Ahyaya/TinyTQ/README.md

# TinyTQ

## 概述

本装置是基于标准直齿轮的轨道演示装置（后称“装置”），用于展示天琴地心轨道设计的基本概念。天琴地心轨道的特点之一是星座平面在绕地心运行的同时会保持其朝向在惯性参考系中大致指向一个与黄道面平行的方向。

通过设计传动比，我们利用一对差速转动的齿轮构造了一个绕太阳平动（仅公转没有自转）的参考工件。我们将代表地球和天琴的工件固连于参考工件上，并通过轴承赋予一个旋转自由度，从而实现了天琴工件绕地运行的同时保持一个固定的空间指向。

此外，装置具有月球演示功能，这里简单叙述一下其实现方法。参考工件是由地日连线工件（后称“连线工件”）进行位置约束的。由于地日连线在每个地球公转周期都绕太阳旋转360°，在参考工件看来连线工件一直在以这一角速度在旋转。考虑到地球工件一个公转周期下，月球工件需要绕参考工件旋转至少13周（月球公转周期约27天），我们采用了二级加速齿轮对连线工件的输入转速进行放大，输出到月球工件使其获得合适的转速。

## 模型清单

| 模型文件 | 部件名称 |
|:---| :-----:|
| D20_ACT_C.stl | 主动轮，即同轴联动齿轮G0a与G0b|
| D225_C2.stl | 限位齿轮G1|
|D120_C2.stl  | 双层齿轮G2|
|D20_external.stl  | 限位齿轮G3|
|Moon_gear_1.stl | 月球加速器中间轴齿轮G4a与G4b|
|D6_withMoon.stl | 月球齿轮G5|
|Sun_root_C.stl | 连接工件P0|
|Earth_root.stl | 参考工件P1|
|TQ_const.stl | 天琴卫星P2|

## 装配关系

主动轮的转轴固定于装置底座（为方便展示并未画出），需要由人拨动其底部的船舵作为驱动动力。连接工件P0的转轴固定于装置底座，并且通过限位齿轮G1来约束自身转角。连接工件P0在水平方向的一端为焊死的直齿轮Gs，齿轮的轴心留有Φ3的通孔用来与参考工件P1进行过盈配合，从而限制P1在水平方向上的位置和旋转。P1在竖直方向上的位置则通过重力约束在Gs上。至此，代表地球心惯性坐标系的P1已经被约束到剩下竖直方向上的旋转。

双层齿轮G2的轴心通孔与P0为过盈配合，限制了G2的空间坐标和水平方向旋转。G2在竖直方向的旋转则受主动轮G0b约束。参考工件P1的底部有限位齿轮G3，通过G3和G2的啮合来最终约束P1在竖直方向上的角度。主动轮G0a、G0b分别与G1、G2均啮合，传动比略有不同，这会导致G1、G2转速成固定比例关系。本设计采用的传动比能确保P1在受P0约束下移动时，能在竖直方向上永远保持一个固定的角度。
天琴卫星工件P2通过水平方向的轴承连接在P1的一端，因而能跟随P1运动的同时沿着某个特定的水平方向自由转动，但P2的转动需要手动拨动该轴承。

齿轮G4a与G4b同轴联动，轴心位置受P1上延伸出的通孔约束，竖直方向转角由G4a与Gs的啮合进行约束。月球齿轮G5中间通孔与P1过盈配合，并且在水平方向上与G4b啮合。因此，Gs-[G4a-G4b]-G5构成了二级齿轮加速，以P1为参考系时Gs充当输入轴，[G4a-G4b]充当中间轴，G5充当输出轴。中间轴的设计决定了月球工件的转速。
