Ahyaya/TinyTQ/D20_external.stl

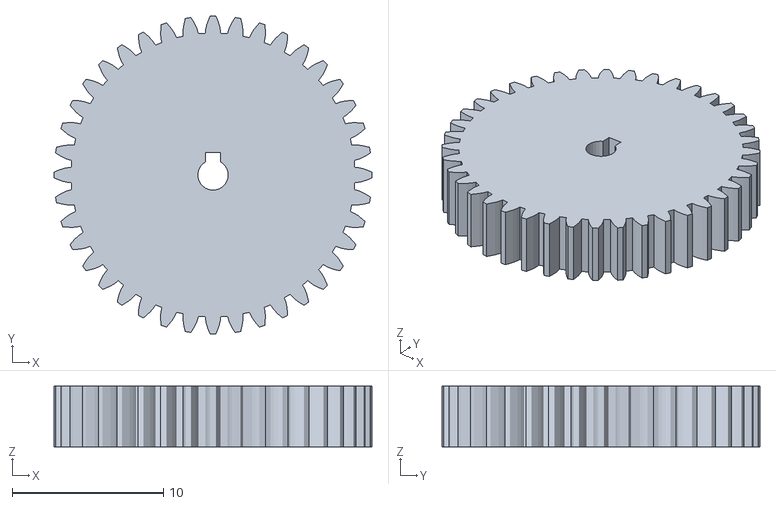
[picture p1: CAD file, 2021-01-09]
D20_external.stl
21.0 x 21.0 x 4.00
