Ahyaya/TinyTQ/D225_C2.stl

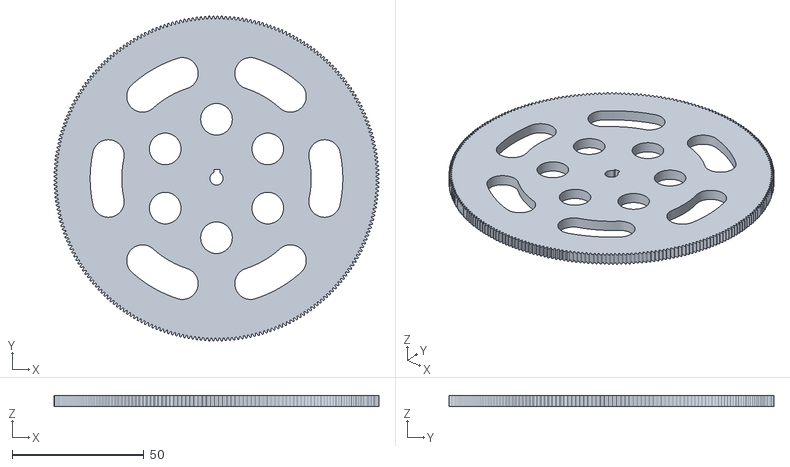
[picture p2: CAD file, 2021-01-09]
D225_C2.stl
123.5 x 123.5 x 4.00
