Ahyaya/TinyTQ/Sun_root_C.stl

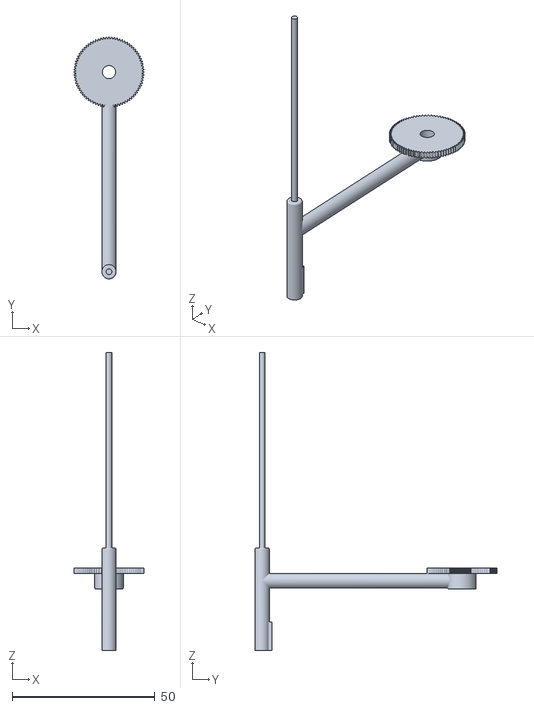
[picture p3: CAD file, 2021-01-09]
Sun_root_C.stl
24.6 x 84.8 x 104.5
