Ahyaya/TinyTQ/Moon_gear_1.stl

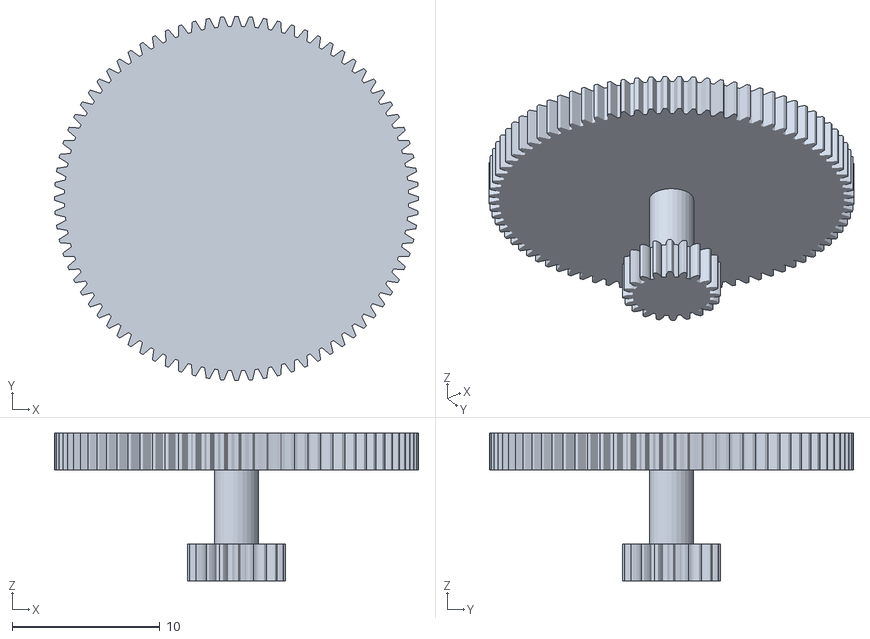
[picture p4: CAD file, 2021-01-09]
Moon_gear_1.stl
24.6 x 24.6 x 10.0
