Ahyaya/TinyTQ/D120_C2.stl

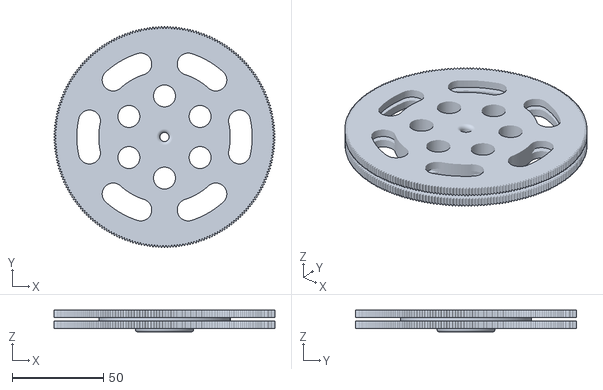
[picture p5: CAD file, 2021-01-09]
D120_C2.stl
121.0 x 121.0 x 12.0
