Ahyaya/TinyTQ/Earth_root.stl

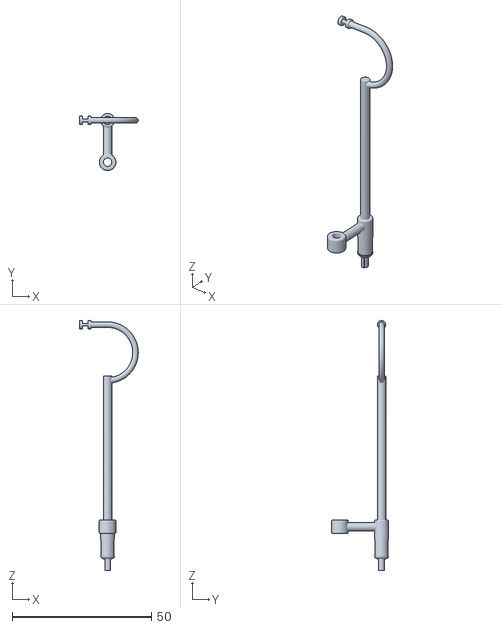
[picture p6: CAD file, 2021-01-09]
Earth_root.stl
21.0 x 20.5 x 89.7
