Ahyaya/TinyTQ/D6_withMoon.stl

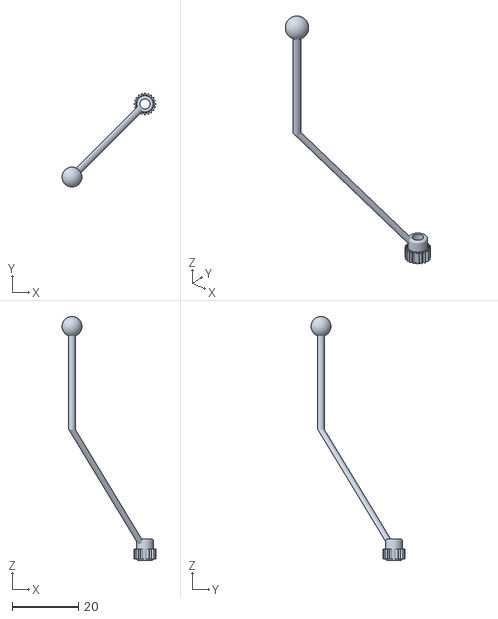
[picture p7: CAD file, 2021-01-09]
D6_withMoon.stl
28.3 x 28.3 x 73.5
