Ahyaya/TinyTQ/TQ_const.stl

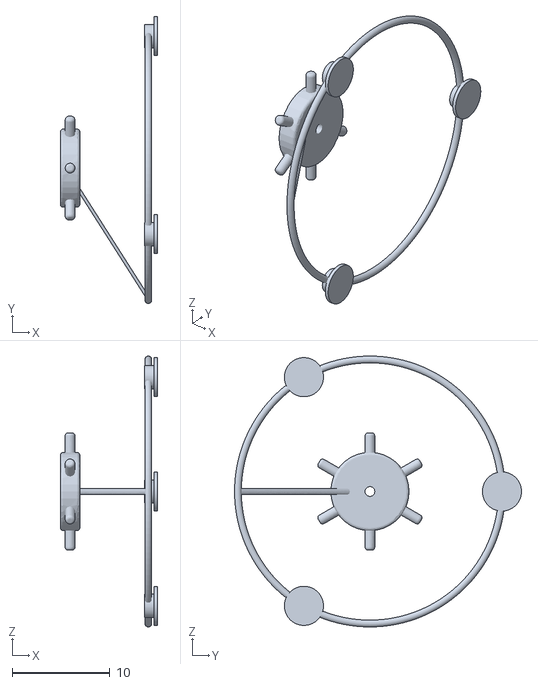
[picture p8: CAD file, 2021-01-09]
TQ_const.stl
9.96 x 29.3 x 27.7
